rahulahooper/audio-relay-client/README.md

## Wireless Audio Transmitter

<figure style="text-align:center">
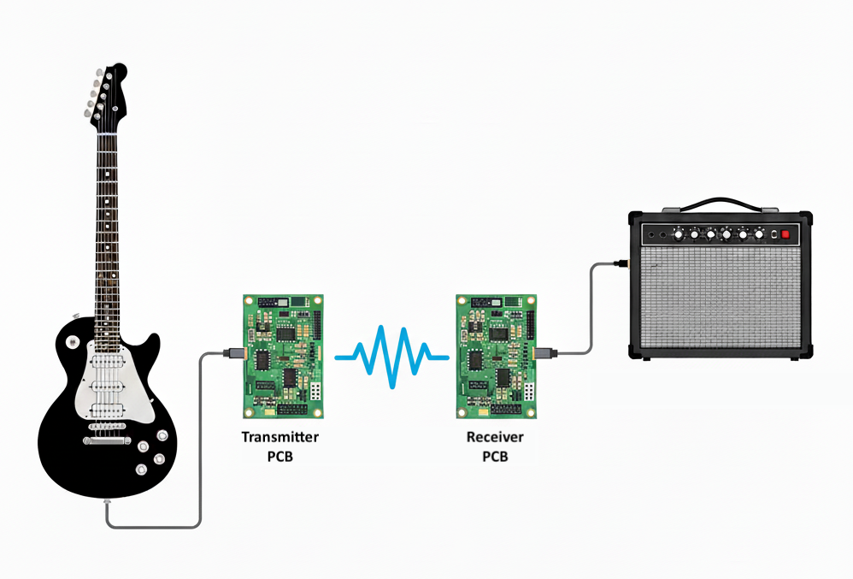
[picture p1: system_diagram.png]
System Diagram
  
  <figcaption>System Diagram</figcaption>
</figure>
<br><br>

This repo is one half of a wireless audio streaming system between two ESP32s.The code here specifically implements the transmitting side of the wireless system. The goal of this repo and the [receiving side](https://github.com/rahulahooper/wireless-audio-receiver/tree/main) of the wireless system is to stream audio from a guitar to an amplifier without having a physical cable between the two. 

The transmitter software consists of two parallel threads (or tasks, in FreeRTOS lingo): the sampling task and the transmit task. 

The sampling task, as its name implies, is responsible for sampling data from a guitar. It specifically interfaces with a [PCM4201](https://www.ti.com/product/PCM4201) analog-to-digital converter (DAC), which communicates over [I2S](https://docs.espressif.com/projects/esp-idf/en/stable/esp32/api-reference/peripherals/i2s.html). The transmit task, on the other hand, is responsible for setting up the Wifi connection with and sending audio data to the receiving ESP32. The task does so using a UDP connection over Wifi. As mentioned before, the two tasks run in parallel, on separate cores. By splitting the sampling and the transmit tasks into two separate threads, we ensure that the software doesn't miss any audio data coming from the ADC.

### Task Synchronization

The two tasks exchange data with one another using [double-buffering](https://wiki.osdev.org/Double_Buffering). The idea is that the sampling task places audio data into a "background packet" while the transmit task simultaneously streams an "active packet" to the receiving ESP32. These two packets are used to avoid contention between the two tasks. That is, the two tasks are always operating on separate packets, never on the same one. When the transmit task successfully sends the active packet to the receiving ESP32, it signals to the sampling task that it needs new data. The sampling task, which periodically polls for this signal, swaps the background and active packets, then signals to the transmit task that new data is available.  

### Theoretical Latency
To compute the theoretical latency of this wireless system, we need to consider:

  1) The amount of time a sample is cached in the transmitting ESP32 before it is sent to the Wifi driver. Samples are cached while the sampling task assembles an audio packet.
      - A sample is cached for _size_of_audio_packet_ / _sampling_rate_ = 300 / 48000 = 6.25ms
  2)  The time it takes for the ESP32s to communicate the data
      - By having the receiving ESP32 periodically echo packets back to the transmitter, we can compute the round-trip time of the wireless communication. 
      - This has been computed to be roughly 3ms --> 1.5ms for one-way communication
  3) The amount of time a sample is cached in the [receiving ESP32](https://github.com/rahulahooper/wireless-audio-receiver/blob/main/README.md) before it is sent to the amplifier
      - The receive task on the receiving ESP32 caches data for some time before sending it to the amplifier. This means that when a sample arrives at the receiving ESP32, there is already about a packet's worth of data in the cache waiting to be sent to the playback task.
      - The approximate amount of time the audio spends in the cache is _size_of_audio_packet_ / _sampling_rate_ = 300 / 48000 = 6.25ms. 

**The theoretical total latency of the audio system, then, is roughly 14ms.** While it should be possible to further reduce the latency by reducing the audio packet size, I personally did not notice the 14ms.

### Circuit

<figure style="text-align:center">
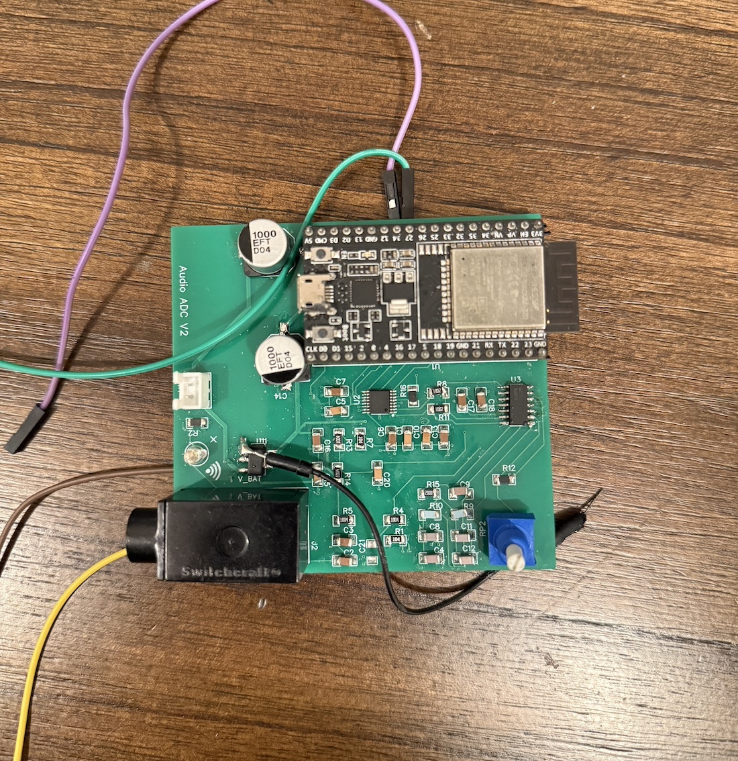
[picture p2: pcb.jpg]
  
  <figcaption>The circuit board, with some debug wires soldered</figcaption>
</figure>
<br><br>

The schematic and layout of the audio transmitter are included in the repo. The circuit is responsible for receiving audio data from a guitar, filtering it, converting it into a differential signal, then sending the differential signal to the PCM4201 ADC.

The circuit requires a little bit more work, as it exhibits a low overall power supply rejection. Specifically, whenever the ESP32 transmits an audio packet, there is a noticeable drop in the 5V supply rail, which powers pretty much everything on the board. As the ESP32 transmits data at a regular interval of 5ms (200Hz), this drop in the 5V rail actually introduces a noticeable 200Hz hum into the audio.

I added some 1mF capacitors to the 5V rail near the ESP32. This has improved the power supply rejection of the audio circuit, but hasn't completely fixed the problem and isn't a great solution. The board is powered off of a 9V battery, which feeds into a 5V linear drop-out regulator (LDO). It's possible that selecting an LDO with a faster response to load fluctuations will fix the problem for good.

The circuit also consumes power like crazy, making it impractical to power the board off of 9V for extended periods of time. I haven't made any direct measurements but I suspect that the WiFi is consuming the most power. While there are some optimizations to make in the softare to make the WiFi less power hungry, a low-hanging fruit in the hardware is the LDO. The LDO converts the battery's 9V supply rail to 5V, which itself gets regulated down to 3.3V by the ESP32. This means that 9V - 3.3V = 5.7V provided by the battery are dissipated as heat.

### Building the project

1. Install the [ESP-IDF](https://docs.espressif.com/projects/esp-idf/en/stable/esp32/get-started/index.html)
2. Compile the code:  `$ idf.py build`
3. Flash the code onto the board: `$idf.py flash`
