rahulahooper/audio-relay-client/schematic.pdf

## A/D Converter Audio Jack (1/4)

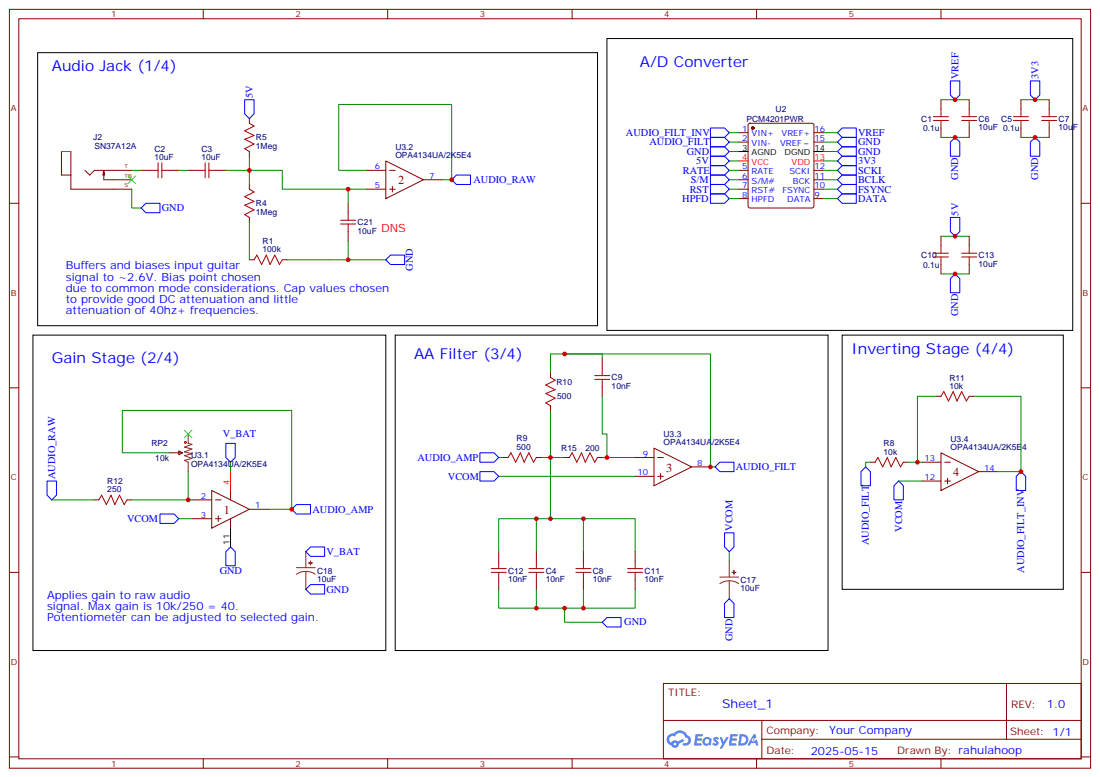
[picture p3: page 1]

Buffers and biases input guitar
signal to ~2.6V. Bias point chosen
due to common mode considerations. Cap values chosen
to provide good DC attenuation and little
attenuation of 40hz+ frequencies.

Applies gain to raw audio
signal. Max gain is 10k/250 = 40.
Potentiometer can be adjusted to selected gain.

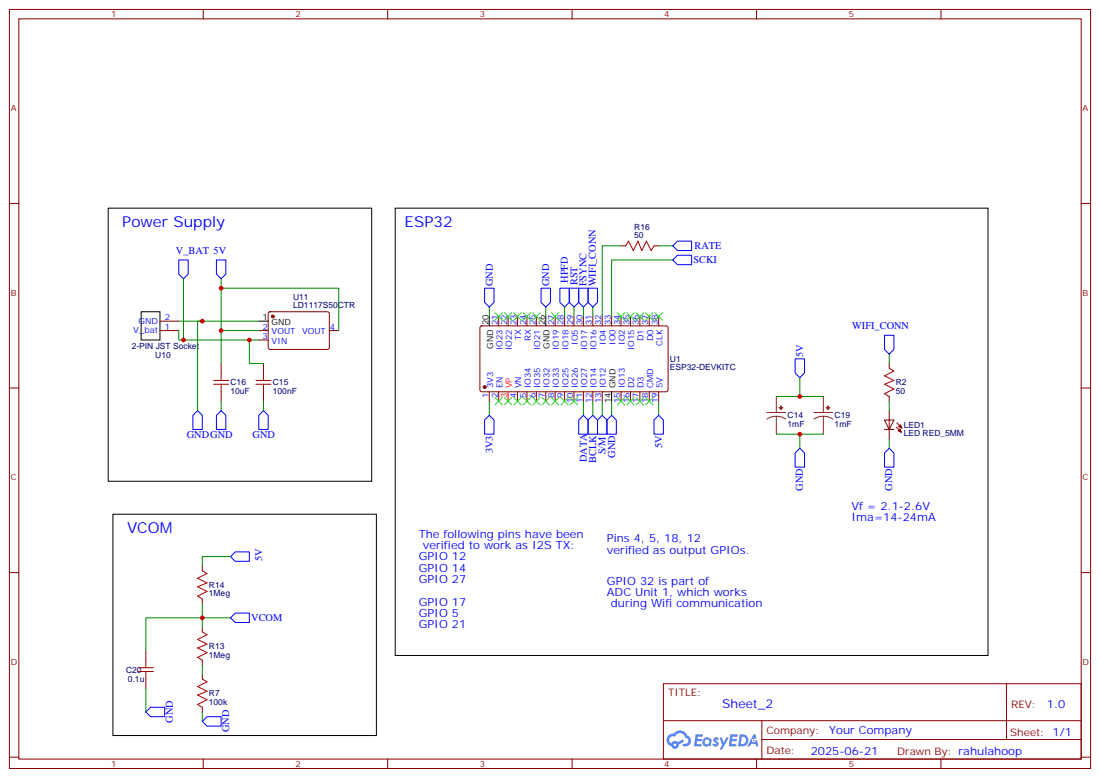
[picture p4: page 2]

The following pins have been
verified to work as I2S TX:
GPIO 12
GPIO 14
GPIO 27
GPIO 17
GPIO 5
GPIO 21

Pins 4, 5, 18, 12
verified as output GPIOs.

GPIO 32 is part of
ADC Unit 1, which works
during Wifi communication
