rahulahooper/audio-relay-client/layout.pdf

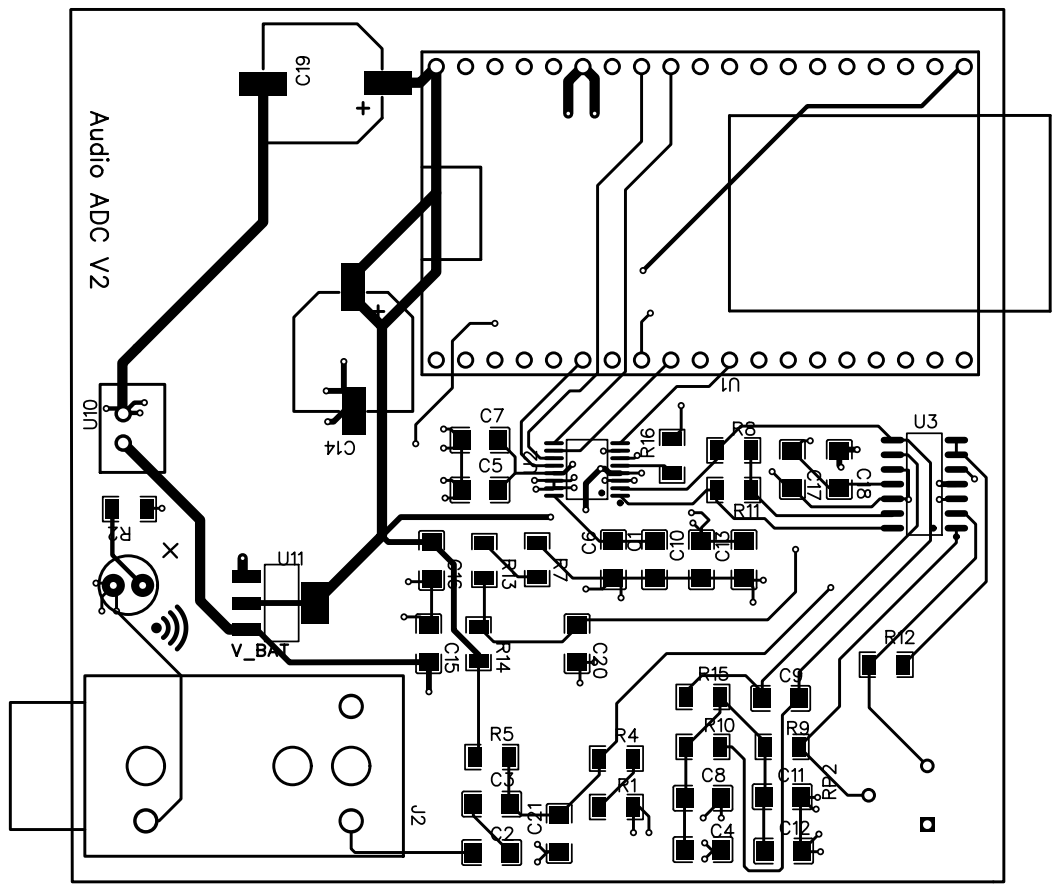
[picture p5: page 1]
