rahulahooper/audio-relay-client/opa4134_adc.asc

C1: cap; 10µF
C2: cap; 40nF
C3: cap; 10µF
C5: cap; 10nF
ESP_DAC: voltage; SINE(0 100mv {f}); AC 1
R1: res; 500
R2: res; 10k
R3: Res; 200
R4: Res; 500
R5: res; 11.5k
R6: res; 100k
R7: res; 100k
R8: res; 5k
R9: res; 250
R10: res; 10k
R11: res; 11.5k
U1: UniversalOpAmp2
U2: UniversalOpAmp2; Avol=1Meg GBW=8Meg Slew=20Meg; Ilimit=25m Rail=0 Vos=1e-3
U3: UniversalOpAmp2
U4: UniversalOpAmp2
V1: voltage; 5
Named nets: 0, Vcc, Vcom, Vsig_amp, Vsig_filt, Vsig, Vsig_buf, Vsig_filt_inv
.ac dec 10 .1Hz 100kHz
.tran 1ms
.step param f list 0 1k
# Uncomment this command for time-domain analysis of signal
# Uncomment this command for frequency-domain analysis of signal
This stage biases the input signal to ~2.6V. This ensures that
the input terminals do not go below the common mode voltage
range of the OPA2134. The capacitor value was chosen to minimize
attenuation of frequencies above DC, and to minimize current draw
from the guitar
This stage is a two-pole lowpass filter with corner frequency ~20kHz
This is a gain stage.
This is stage provides an inverted signal. The inverted and
non-inverted signals together provide a differential signal
to the ADC. 
To save on parts, we could replace the inverted signal with Vcom. 
In this case, and assuming the non-inverted signal varies from
rail to rail, the ADC will measure a 2.5 Vpp signal and output a 
corresponding PCM signal. If we provide an inverted signal, the ADC
will measure a 5Vpp signal. The trade off is therefore between part
cost and ADC resolution.
