rahulahooper/audio-relay-client/(commit log)

2025-03-23 Add timer-based interrupt for sampling
2025-03-23 Add states for creating and destroying socket fd
2025-09-12 Fix memory, watchdog timer issues and add dma buffer overflow callback
2025-09-15 Increase audio packet capacity to reduce buffer overflows on server
2025-11-07 Throttle I2S DMA reads, add WiFi connected LED, timer and traffic meter tools
2025-12-11 Don't track extra config files in git
2025-12-12 Add image of pcb
